imaqone/bilibiliCamera/3DFile/天线左.stl

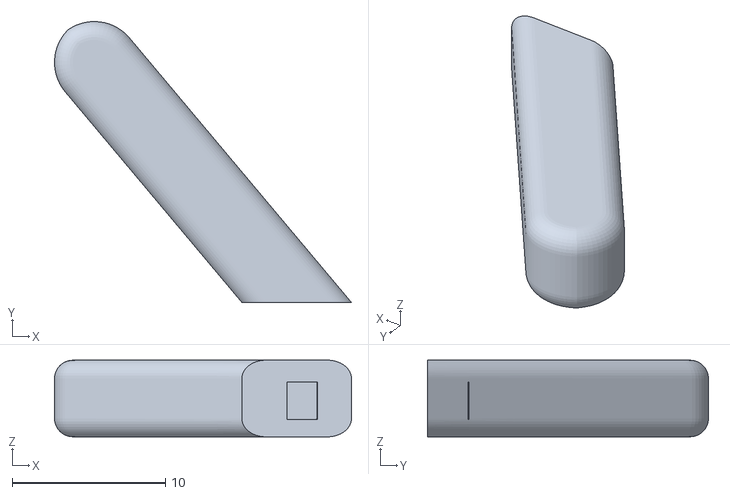
[picture p5: CAD file, 2021-05-07]
3DFile/天线左.stl
19.4 x 18.3 x 5.00
