imaqone/bilibiliCamera/3DFile/左9.stl

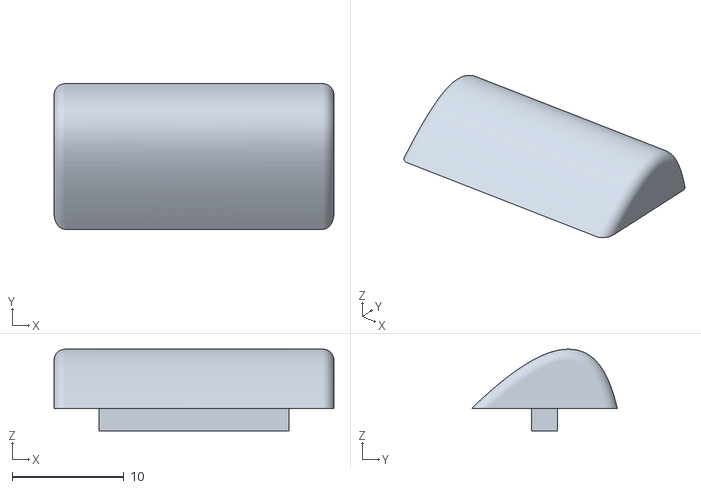
[picture p6: CAD file, 2021-05-07]
3DFile/左9.stl
25.0 x 13.0 x 7.29
