imaqone/bilibiliCamera/3DFile/顶壳.stl

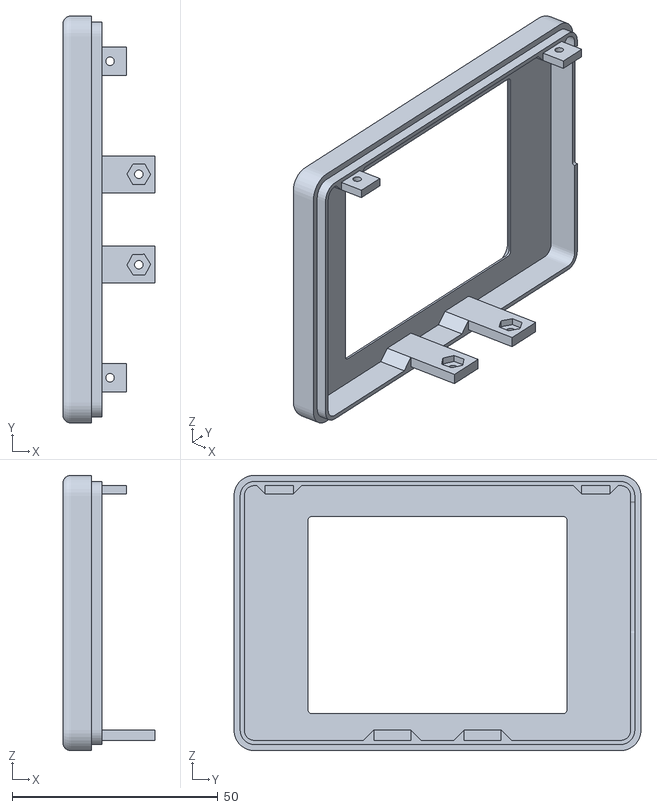
[picture p7: CAD file, 2021-05-07]
3DFile/顶壳.stl
22.5 x 99.0 x 67.0
