imaqone/bilibiliCamera/3DFile/底壳.stl

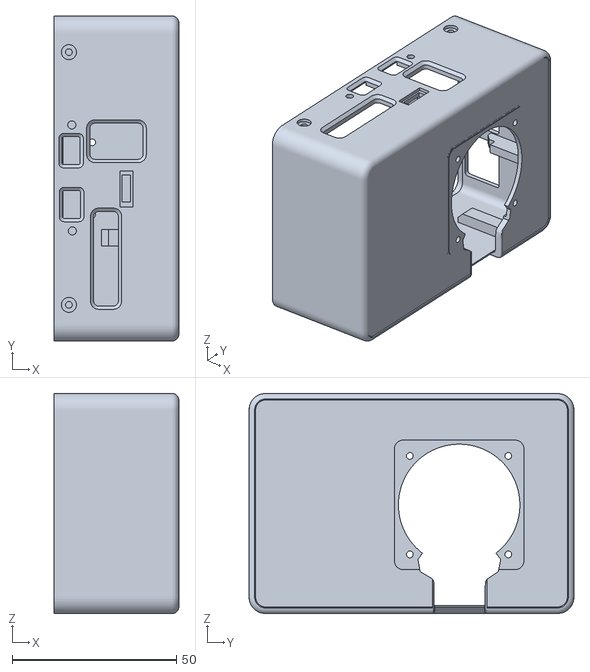
[picture p8: CAD file, 2021-05-07]
3DFile/底壳.stl
38.0 x 99.0 x 67.0
