imaqone/bilibiliCamera/(list of files, cad)

Other CAD files:
3DFile/天线右.stl
